ElektorLabs/210043-CO2-Guard/Hardware/Project_KiCad6/CO2Guard/twco2sensor-mh-z19b/README.md

KiCad Lib für den Co2 und Temp. Sensor MH-Z19B.

Hersteller des Co2 und Temp.-Sensors https://www.winsen-sensor.com/sensors/co2-sensor/mh-z19b.html

KiCad Symbol ( besteht aus .lib und .dcm Dateien ):



KiCad Footprint ( Verzeichnis mit .pretty suffix und darin die .kicad_mod Dateien):



Mehr zur Verwendung dieser Lib auf http://blog.wenzlaff.de/?p=15391
