ElektorLabs/210043-CO2-Guard/(threads)

Thread 1 (2022-04-06):

Board revision doesn't work

SchneHa, 2022-04-06:
Unfortunately, the new circuit board revision does not work as it is! Once it is set up, the D1 mini cannot be started and can no longer be programmed. This is because D8 is connected to the buzzer through the resistor network and T1. This pulls D8 to HIGH potential and prevents starting. If resistor R2 is disconnected from D8, it works. But then, of course, the buzzer no longer works.

I suggest connecting the cathode of LED C to D8 instead of D5. Then D5 would be free for the buzzer. However, you could also put the cathode of LED C permanently on GND, in my opinion it only has a decorative function anyway.

lab-mathias-claussen, 2022-04-07:
Hi SchneHa,

we will fix the Pin-assignment and move the pins arround. Also for the Buzzer it may be an idea to drive it on the low side instad of a highside drive, as this would allow for a Pull-Down.

Best Regards

Mathias Claußen

calm4git, 2022-04-08:
Hi,

i just created a new Pull_equest that shoudl fix the pinout and set it as following:

D1/D2 (I²C) connected to pinheader
D3/D4 RX/TX Sensor
D0 LED R
D7 LED C
D6 LED Y
D5 Buzzer
D8 LED G

SchneHa, 2022-04-08:
Wonderful, I will order the PCBs and will do a test.

lab-mathias-claussen, 2022-04-11:
New revision has been merged into the repository so version 2.4 can be tested

Closed 2022-04-25.

Thread 3 (2022-05-20):

Suggestion: Change I²C-pin order to match BME280 breakout

SchneHa, 2022-05-20:
If you make another revision of the PCB I suggest to put the I2C pins in the right order for BME280 breakout board. That is:
VIN - GND - SCL - SDA
On last revision of PCB it is VIN - SCL - SDA - GND

That will it make easy to connect BME280 sensor with soldered pin header to socket strips on PCB without any wires.

lab-mathias-claussen, 2022-05-30:
Hi,

swap would be in next PCB revision. Currently no timeline is scheduled for this change.

lab-mathias-claussen, 2022-06-01:
As this PCB has some additional changes in it i would like to keep 2.6 as having two 2.5 versions somewhere is never a good idea in the long term.

Closed 2022-06-01.
