ElektorLabs/210043-CO2-Guard/Software/Arduino/CO2Guard/webfunctions.h

#ifndef WEBFUNCTION_H_
#define WEBFUNCTION_H_

/**************************************************************************************************
*    Function      : response_settings
*    Description   : none
*    Input         : none
*    Output        : none
*    Remarks       : none
**************************************************************************************************/     
void response_settings( void );


/**************************************************************************************************
*    Function      : ntp_settings_update
*    Description   : none
*    Input         : none
*    Output        : none
*    Remarks       : none
**************************************************************************************************/ 
void ntp_settings_update( void );


/**************************************************************************************************
*    Function      : timezone_update
*    Description   : none
*    Input         : none
*    Output        : none
*    Remarks       : none
**************************************************************************************************/ 
void timezone_update( void );


/**************************************************************************************************
*    Function      : timezone_overrides_update
*    Description   : none
*    Input         : none
*    Output        : none
*    Remarks       : none
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
*    Description   : Parses POST for new MQTT settings 
*    Input         : none
*    Output        : none
*    Remarks       : none
**************************************************************************************************/
void mqttsettings_update( void );


/**************************************************************************************************
*    Function      : Reads back the MQTT settings
*    Description   : Sends a json string 
*    Input         : none
*    Output        : none
*    Remarks       : only contains if a password is set no data itself
**************************************************************************************************/
void read_mqttsetting( void );

void SetThingspeakServerSettings( void );

void GetThingspeakSeverSettings( void );
#endif
