ElektorLabs/210043-CO2-Guard/Software/Arduino/CO2Guard/buzzer.h

class BUZZER 
{
private:
        
        int pin_buzzer;
        int tone_value;
        
public:
        
        BUZZER(int pin_buzzer, int tone_value);
        
        void setBuzzer ();
        void clearBuzzer ();
        
};
