ElektorLabs/210043-CO2-Guard/(commit log)

2022-01-05 Added Projectfiles
    Added Gerber Files ( Altium )
2022-01-05 Added KiCad6 Project
    Added KiCad 6 Projectfiles
    [CO2Guard.kicad_pcb, CO2Guard.kicad_sch]
2022-02-02 Fixed configuration settings
    Swapped RX/TX pin fixed.
    Leds will be active for one second after boot
    [configure.h, main.cpp]
2022-02-03 Fixed Buzzer
    Buzzer was not working as intended. Changed setup to set PWM Range and FREQUENCY for analogWrite()
    Also some small code cleanups
    Buzzer will now sound 1 second at boot
    [alarm.cpp, alarm.h, buzzer.cpp, main.cpp]
2022-02-14 Swapped Layer and fixed Antenna keepout
    Switched Top and bottom layer to be in line with the Altium version
    Fixed a small bug with the Antenna keep out area
    [CO2Guard.kicad_pcb]
2022-02-23 Changed Pinout for I²C Access
    Pins have been changed to free up I²C Bus
    [CO2Guard.kicad_pcb, CO2Guard.kicad_sch]
2022-04-08 Fixed problem with boot
    Swapped Pins so D8 is low at boot
    D1/D2 (I²C) connected to pinheader
    D3/D4 RX/TX Sensor
    D0 LED R
    D7 LED C
    D6 LED Y
    D5 Buzzer
    D8 LED G
    [CO2Guard.kicad_pcb, CO2Guard.kicad_sch]
2022-04-09 Modified T1 Footprint
    Footprint of T1 has been modified to be more "user" friendly
    [CO2Guard.kicad_pcb]
2022-05-09 ArduinoIDE Version added, bug fixed
    Added Arduino Version of the Code. Also fixed a Bug within the EEPROM.
    [CO2Guard.ino, Lights.h, alarm.cpp, alarm.h, buzzer.cpp, buzzer.h, co2.cpp, co2.h]
2022-06-01 Update for Issue #3
    Suggested by user SchneHa the I²C Pinout is changed to match the BME280 sensor.
    Revision 2.5 was submitted by SchneHa and has been merged. Revision 2.6 added some cosmetics and pinout description on the PCB.
    [CO2Guard.kicad_pcb, CO2Guard.kicad_sch]
